NeurologicalMichael/Autonomous-Drone-Legal-/Sf075e33a5f654c38a569ff08e518d822D.webp

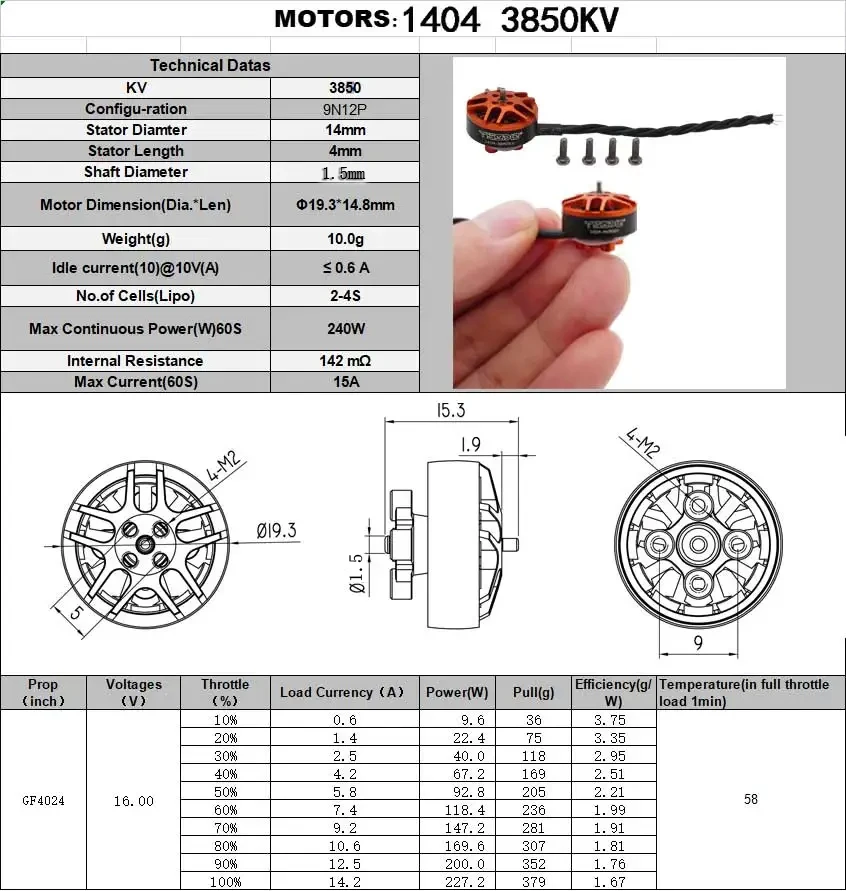
Sf075e33a5f654c38a569ff08e518d822D.webp
