NeurologicalMichael/Autonomous-Drone-Legal-/Drone_Practice Clean Build.stl

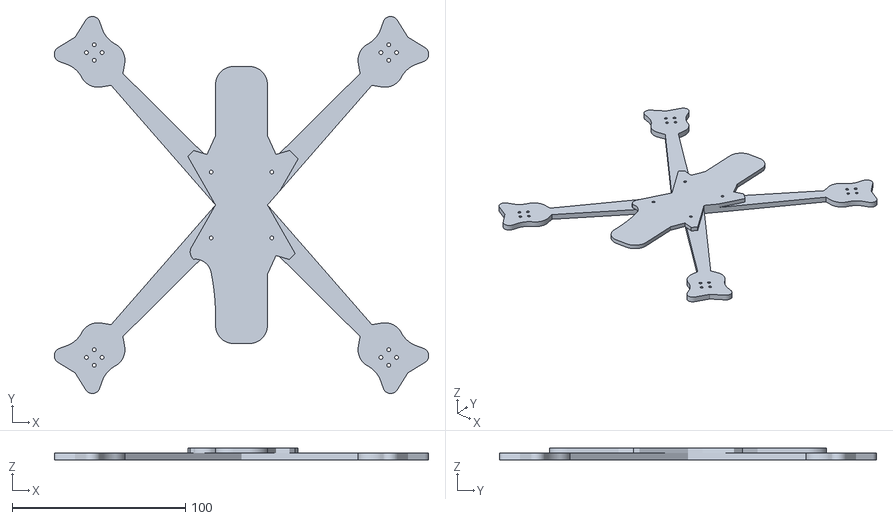
[picture p2: CAD file, 2026-08-27]
Drone_Practice Clean Build.stl
216.1 x 217.6 x 7.00
