NeurologicalMichael/Autonomous-Drone-Legal-/(list of files, drawings)

Other design files:
Finished Autonomous Drone PCB.dsn
