NeurologicalMichael/Autonomous-Drone-Legal-/Finished Autonomous Drone PCB.kicad_pcb

## KiCad design Finished Autonomous Drone PCB.kicad_pcb (2026-09-09)

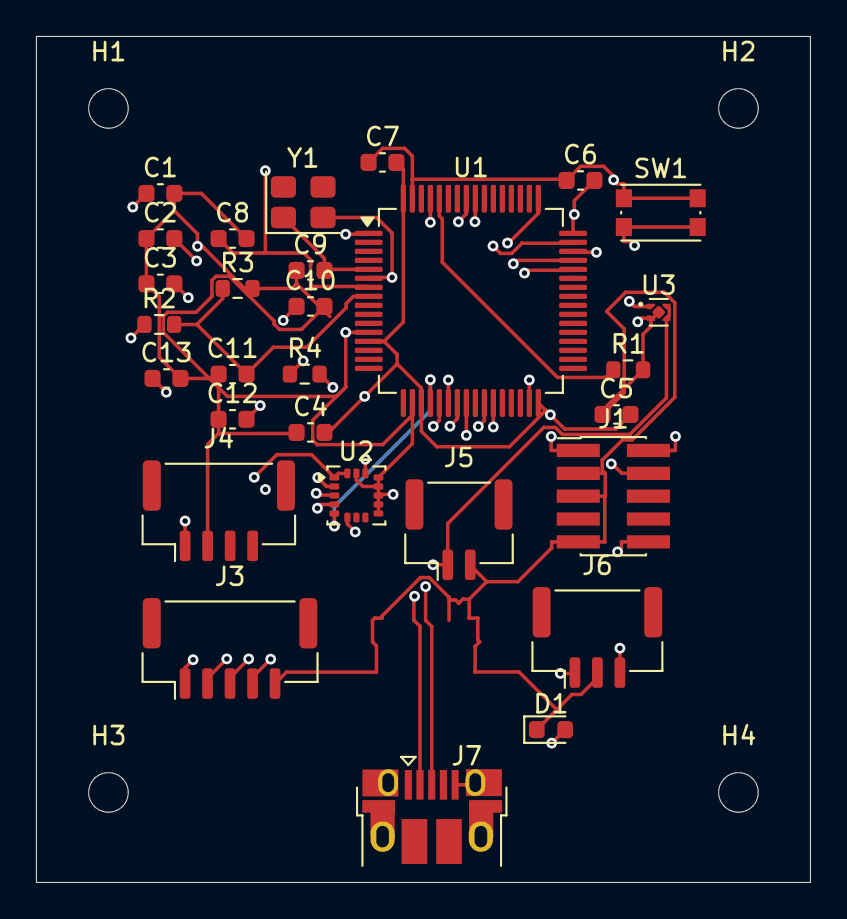
[picture p3: board Finished Autonomous Drone PCB.kicad_pcb from above]

Board: 4 copper layers, 43.0 x 47.0 mm, 33 parts (0 on the bottom side), 28 nets.

Parts:
C1, C4, C5, C6, C7: 0.1uF; C_0603_1608Metric
C2, C3: 2.2; C_0603_1608Metric
C8: 0.1 µF; C_0603_1608Metric
C9, C10: 8.2; C_0603_1608Metric
C11: 100nF; C_0603_1608Metric
C12, C13: 1 µF; C_0603_1608Metric
D1: LED; LED_0603_1608Metric
H1, H2, H3, H4: MountingHole_2.2mm_M2
J1: Conn_ARM_JTAG_SWD_10; PinHeader_2x05_P1.27mm_Vertical_SMD
J3: Conn_01x05; JST_GH_BM05B-GHS-TBT_1x05-1MP_P1.25mm_Vertical
J4: Conn_01x04; JST_GH_BM04B-GHS-TBT_1x04-1MP_P1.25mm_Vertical
J5: Conn_01x02; JST_GH_BM02B-GHS-TBT_1x02-1MP_P1.25mm_Vertical
J6: Conn_01x03; JST_GH_BM03B-GHS-TBT_1x03-1MP_P1.25mm_Vertical
J7: USB_B_Micro; USB_Micro-B_Amphenol_10103594-0001LF_Horizontal
R1, R3: 10k; R_0603_1608Metric
R2: 47k; R_0603_1608Metric
R4: 1; R_0603_1608Metric
SW1: SW_Push; SW_Push_1P1T_NO_CK_KMR2
U1: STM32F405RGTx; LQFP-64_10x10mm_P0.5mm
U2: ICM-20602; LGA-16_3x3mm_P0.5mm_LayoutBorder3x5y
U3: TPS7A20xxxDQN; Texas_X2SON-4_1x1mm_P0.65mm
Y1: Crystal; Crystal_SMD_3225-4Pin_3.2x2.5mm

Connections:
+3.3V: C4.2, C5.2, C6.2, C7.2, C13.1, U1.13 (VDDA), U1.19 (VDD), U1.32 (VDD), U1.48 (VDD), U1.64 (VDD)
+3V3: J1.1 (VTref), J4.1, U1.1 (VBAT), U2.1 (VDDIO), U2.16 (VDD), U3.1 (OUT)
/5V_INPUT: C12.2, J5.1, J6.1, U3.3 (EN), U3.4 (IN)
/BAT_RAW: J6.3, R2.1
/NSRT: C8.1, J1.10 (~RESET), SW1.2, U1.7 (NRST)
/[MOTOR1]: J3.1, U1.56 (PB4)
/[MOTOR2]: J3.2, U1.57 (PB5)
/[MOTOR3]: J3.3, U1.26 (PB0)
/[MOTOR4]: J3.4, U1.27 (PB1)
/[VBAT_SENSE]: C11.2, R2.2, R3.1, U1.8 (PC0)
GND: C1.2, C2.1, C3.1, C4.1, C5.1, C6.1, C7.1, C8.2, C9.1, C10.2, C11.1, C12.1, C13.2, D1.1 (K), J1.3 (GND), J1.5 (GND), J1.9 (GNDDetect), J3.5, J4.2, J5.2, J6.2, J7.5 (GND), J7.SH (Shield), R1.2, R3.2, SW1.1, U1.12 (VSSA), U1.18 (VSS), U1.63 (VSS), U2.9 (GND), U2.10 (GND), U2.11 (GND), U2.12 (GND), U2.13 (GND), U2.15 (GND), U3.2 (GND), U3.5 (Pad)
unnamed: D1.2 (A), R4.2
unnamed: J1.4 (SWCLK/TCK), U1.49 (PA14)
unnamed: J1.2 (SWDIO/TMS), U1.46 (PA13)
unnamed: J7.3 (D+), U1.45 (PA12)
unnamed: J7.2 (D-), U1.44 (PA11)
unnamed: R1.1, U1.60 (BOOT0)
unnamed: U1.20 (PA4), U2.5 (~CS)
unnamed: U1.21 (PA5), U2.2 (SCL/SPC)
unnamed: U1.22 (PA6), U2.4 (SAO/SD0)
unnamed: U1.23 (PA7), U2.3 (SDA/SDI)
unnamed: R4.1, U1.61 (PB8)
unnamed: U1.24 (PC4), U2.6 (INT)
unnamed: C9.2, U1.5 (PH0), Y1.1
unnamed: C10.1, U1.6 (PH1), Y1.2
unnamed: C2.2, U1.31 (VCAP_1)
unnamed: C3.2, U1.47 (VCAP_2)
unnamed: C1.1, U2.14 (REGOUT)
